danielulloa/dual_ad9833_scpi/informe_ulloa_daniel.pdf

## GENERADOR DE SENALES ˜

Daniel Ulloa
Departmento de Electronica ´ UNPSJB
Comodoro Rivadavia, 9000
ulloa@ieee.org

28 de junio de 2021

ABSTRACT

Desarrollo y fabricacion de un Generador de Se ´ | nales de dos Canales utilizando m ˜ | odulos AD9833 y ´
Arduino Uno. El intrumento puede ser programado utilizando el protocolo SCPI-1993 en formato de
texto plano a traves del puerto serie emulado por el conversor USB-TTL del Arduino Uno. Se logr ´ | ó
el ajuste de offset y ganancia con amplificadores operacionales, utilizando un circuito integrado MAX232 para generar la tension sim ´ etrica a partir de los 5V del puerto USB. ´

### 1. Objetivos

La catedra de Instrumentos y Mediciones 2 plante ´ | o el desarrollo de un instrumento digital que sea capaz de: ´

Generar dos senales ˜

Forma de onda seleccionable

Control de nivel DC offset a la salida

Control externo de la frecuencia

Control externo de la amplitud de salida

Se debe utilizar un Arduino Uno y modulos AD9833. ´

### 2. Decisiones de Disenõ

Para cumplir con los primeros dos objetivos el uso del modulo AD9833 permite una frecuencia de salida de 0 a ´ 12.5MHz y tres formas de onda seleccionables mediante configuracion de registros internos. ´

Respecto al control de offset y amplitud se analizo la posibilidad de utilizar un potenci ´ | ometro digital X9C10x que ´
requiere de una tension sim ´ | etrica de ´ | ±5V. Para generar esta tension s ´ | olo se encontr ´ | o el circuito integrado ICL7660 ´
pero no disponible localmente. La desventaja de utilizar un potenciometro digital es que s ´ | olo se podr ´ | ía atenuar la
frecuencia y la senal estar ˜ | ía limitada a ± 5V. Si se utilizara como resistencia de realimentaci ´ | on en un amplificador ´
operacional en configuracion no inversor se ver ´ | ía afectada su funcion de transferencia ya que el modelo de peque ´ | nã
senal est ˜ | a compuesto por capacitancias par ´ | asitas y la excursi ´ | on tambi ´ | en seguir ´ | ía limitada a ± 5V.

Para alimentar el amplificador operacional sería posible utilizar un circuito integrado MAX232, 2 capacitores de
bootstrap y 2 capacitores de filtrado para que genere una tension sim ´ | etrica de ´ | ± 8V a partir de los 5V disponibles.

Respecto al control de offset, el modulo AD9833 tiene un offset siempre positivo y es por esto que, se analiza la ´ posibilidad de utilizar una senal PWM filtrada para tener un valor de continua y un amplificador operacional en ˜
configuracion restador lo que permitiría desplazar a valores negativos la senal. Una alternativa ser ˜ | ía el uso de un
modulo DAC ya que la se ´ | nal PWM filtrada contiene una componente fundamental de 490Hz. ˜

Generador de Senales ˜

Para el control de ganancia una configuracion no inversor era la ´ | unica opci ´ | on ya que el mayor n ´ | umero de amplifi- ´
cadores operacionales en un circuito integrado es de 4 unidades, quedando dos disponibles para esta operacion. Una ´
configuracion inversor seguido de otro inversor de ganancia unitaria permitir ´ | | ía atenuacion y ganancia. Para ajustar la ´
realimentacion se estudia la posibilidad de utilizar un Optoaislador Resistivo fabricado utilizando un LDR de 5mm y ´ un LED Verde de 5mm, que podría ser controlado con otro puerto PWM del microcontrolador.
Para el control externo de la amplitud de salida de forma tal de obtener una senal modulada, no se encontr ˜ | o una ´
solucion. ´

Adicionalmente se propone la implementacion del protocolo SCPI-1993 que permite automatizar un banco de instru- ´ mentos, siendo posible el ajuste de parametros mediante software. ´

### 3. Esquema

El siguiente esquema representa una posible implementacion que permite el control de la ganancia y offset. Se utilizar ´ | ía
un lazo de realimentacion con un circuito muestreador que permita realizar la medici ´ | on de amplitud. ´

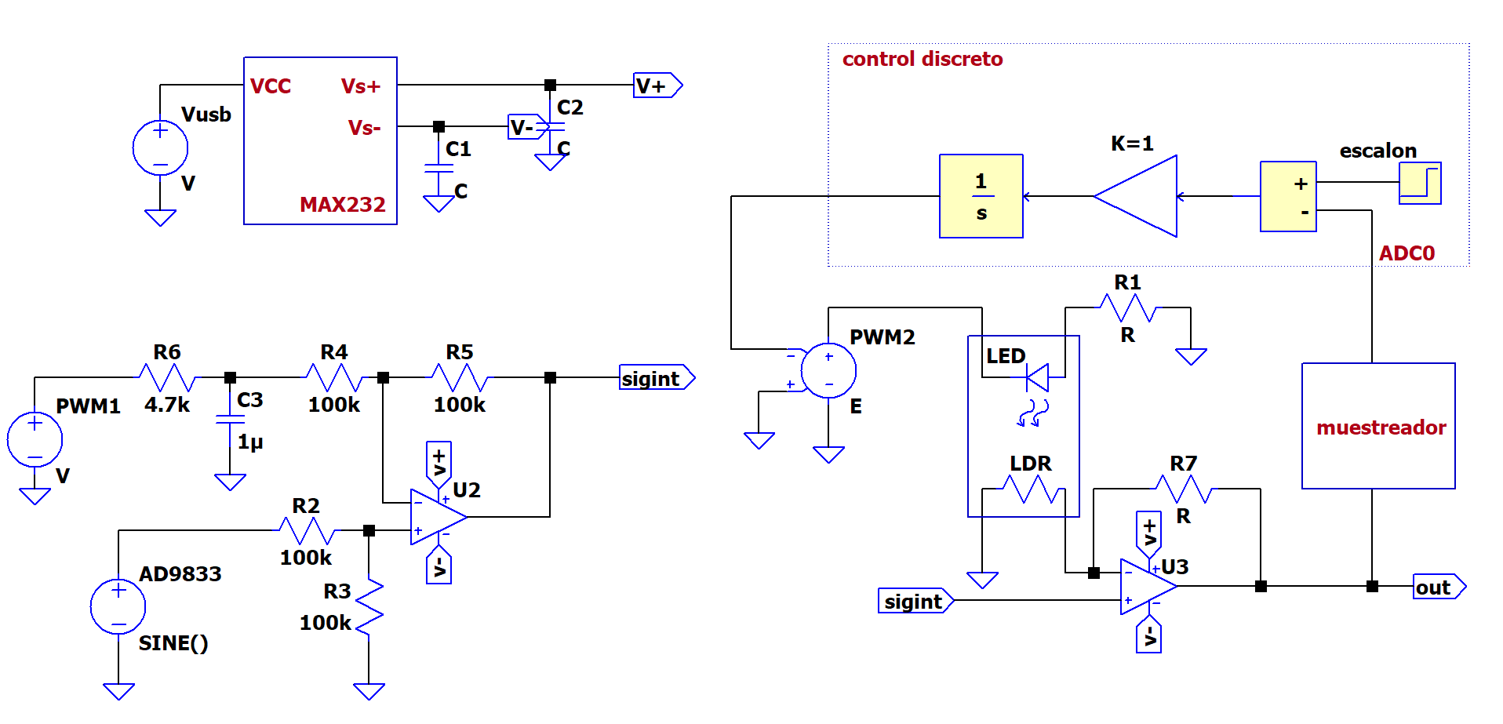
[picture p3: figure]

Figura 1: Primer esquema planteado, requiere de controlador discreto implementado en el microncontrolador

El problema de esta implementacion es que requiere de un circuito tal que detecte la envolvente para un amplio rango ´ de frecuencias.

Realizando un ensayo del LDR, que consitía de un divisor resistivo conectado a un puerto ADC del microcontrolador
y un LED verde frente al LDR con una senal PWM de 8 bits, se encontr ˜ | o que era posible utilizarlo en una regi ´ | on lineal ´
dependiente de un rango de valores PWM.

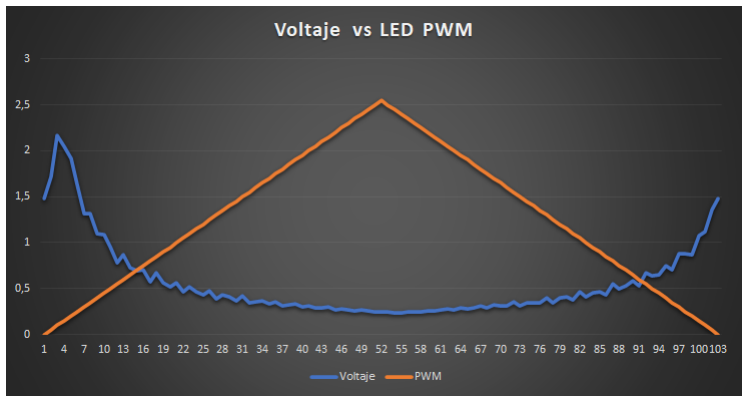
[picture p4: figure]

Figura 2: Barrido del ancho de pulso de la senal PWM para obtener la caracter ˜ | ística del LDR

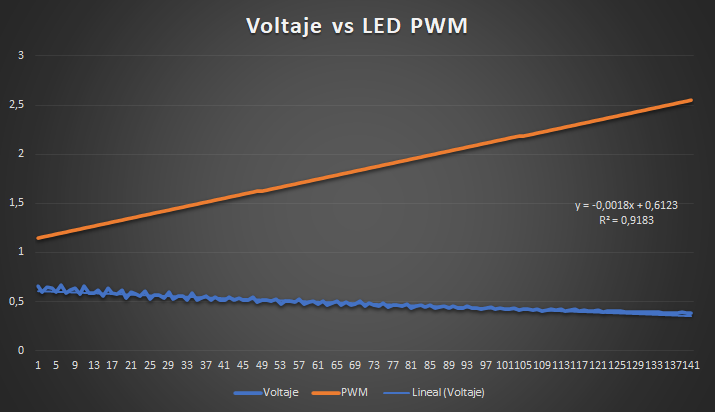
[picture p5: figure]

Figura 3: Limitando el rango a valores entre 115 y 255 se obtiene una recta, se verifica mediante una regresion lineal ´ que el coeficiente R es de 0.918

En base a los resultados del ensayo se limito el ancho de pulso que ser ´ | ía controlado por el software para ajustar la
ganancia de la senal de salida. El esquema final no implementa el lazo de realimentaci ˜ | on. ´

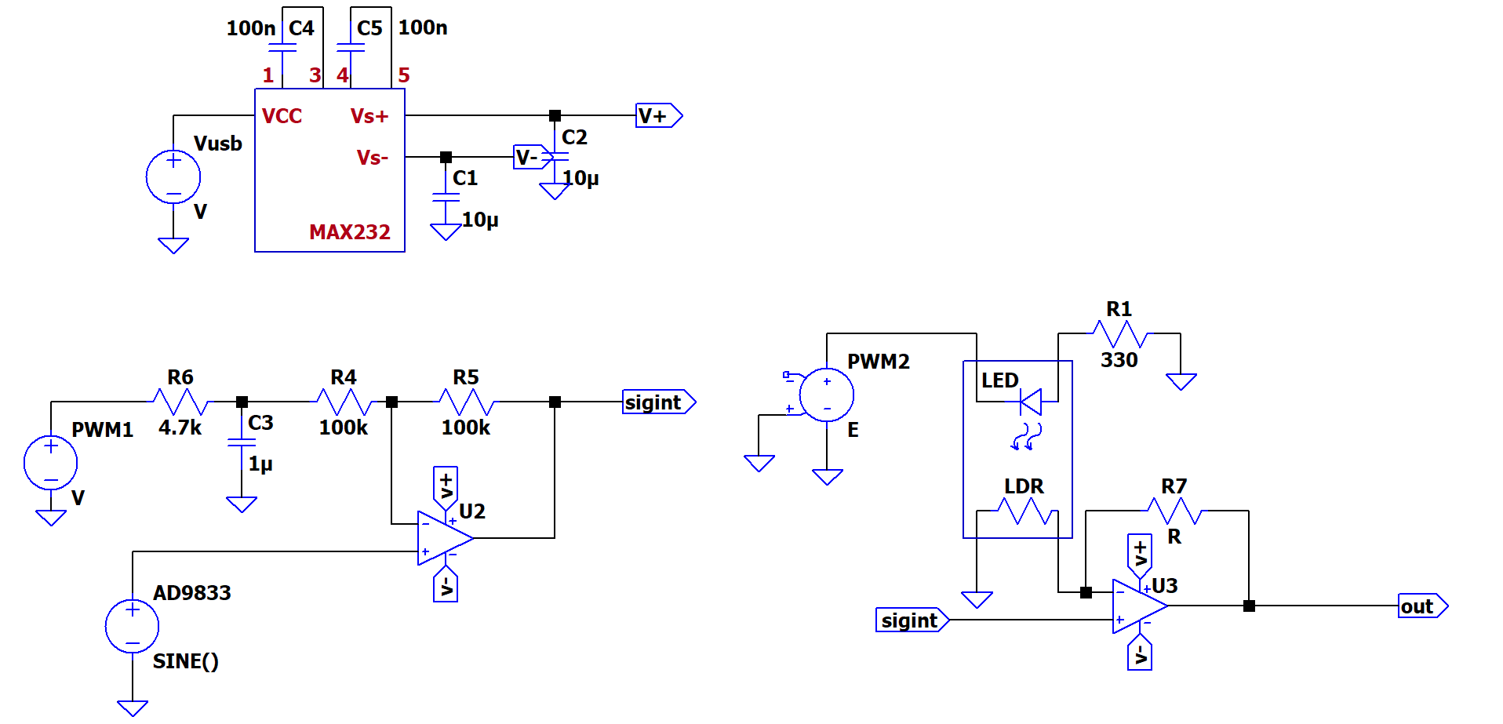
[picture p6: figure]

Figura 4: Esquema final, utiliza al LDR en su region lineal lo que permite obviar el esquema de control para el elemento ´ no lineal

### 4. Etapa de Prototipo

Primero era necesario verificar el funcionamiento de la fuente implementada con MAX232 y si la corriente era sufi-
ciente para alimentar un amplificador operacional cuadruple. Se dispon ´ | ía de un amplificador operacional OPA4277 y
un OPA4228, a continuacion sus caracter ´ | ísticas y motivos de eleccion. ´
IC | OPA4228 | OPA4277
GBW | 8MHz | 1MHz
SR | 2.3V/us | 0.8V/us
THD | 0.00005 % | 0.002 %
PSRR | 126dB | 130dB
Offset | ±75uV | ±10uV
Input Bias | 10nA | 1nA

La tension de alimentaci ´ | on provista por el MAX232 contiene ruido de alta frecuencia y es por esto que se eligi ´ | ó
el OPA4277 aunque sus características de alta frecuencia limitan la frecuencia maxima de operaci ´ | on. En teor ´ | ía sería
necesario el uso de un amplificador operacional con un producto ganancia superior a 100MHz para tener una tension de ´ salida de 5Vpp y un Slew Rate superior a 390V/us. Si se limita la frecuencia maxima para la onda cuadrada a 20kHz el ´ SR debe ser superior a 0.628V/us, por lo tanto el OPA4277 cumple. En el caso de querer mejorar la frecuencia maxima ´ conservando el formato DIP de 14 pines, un amplificador operacional con las características mencionadas podría ser LT1230CN u OPA4658P, pero no se encuentran disponibles en nuestro país y sería necesaria su importacion mediante ´ un distribuidor internacional.

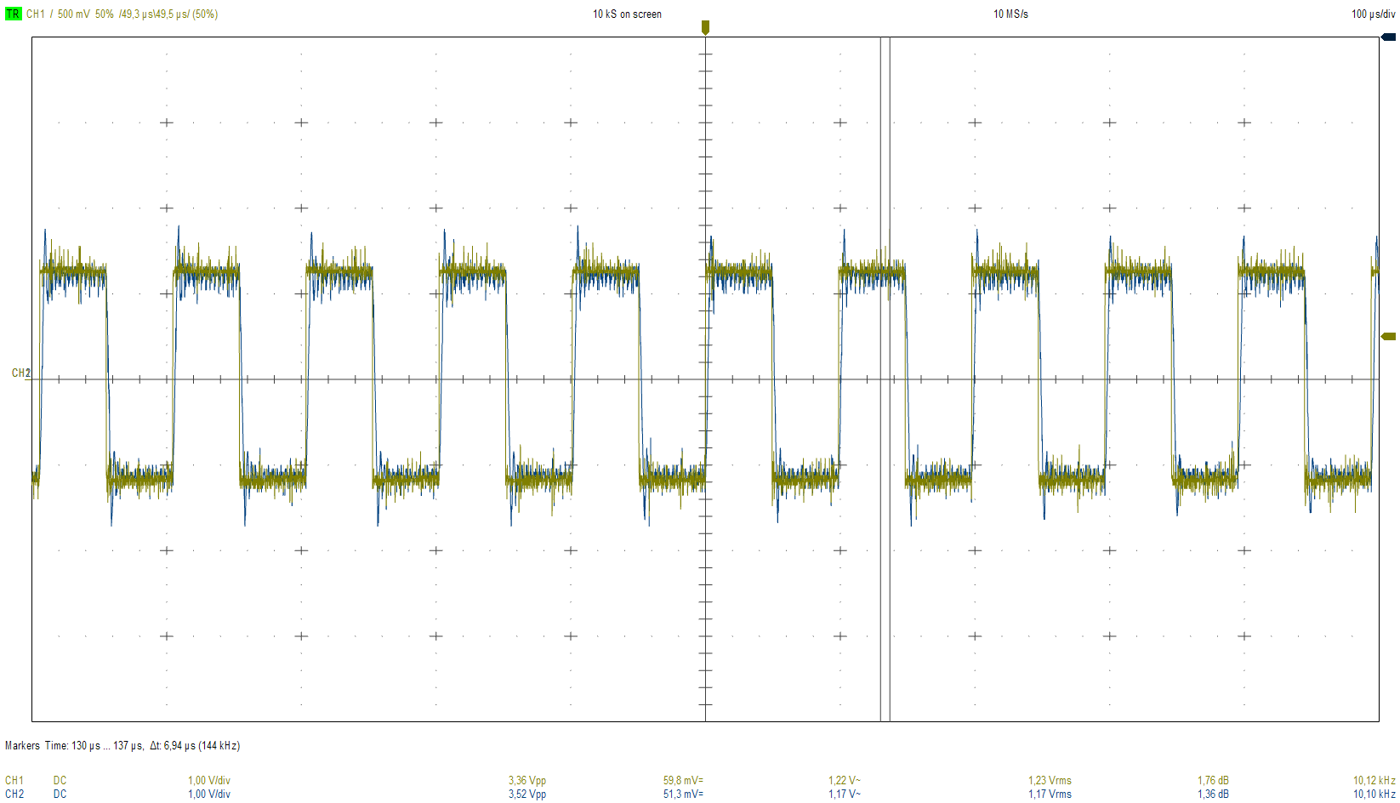
[picture p7: figure]

Figura 5: Implementacion en protoboard. Se observa un ruido de alta frecuencia del generador de funciones utilizado ´ para el ensayo.

Los resultados obtenidos fueron satisfactorios y se decidio implementar el circuito en un ProtoShield para Arduino, ´
que dispone de un area limitada para soldar los componentes de todo el circuito, pero con las t ´ | ecnicas adecuadas y ´
disposicion de los componentes ser ´ | ía posible minimizar el ruido. Al momento de probar la placa se encontro que el ´
circuito integrado MAX232 era defectuoso lo cual aumentaba el ruido así como tambien una reducci ´ | on en su voltaje ´
simetrico, de aproximadamente 3V. Con un nuevo circuito integrado se obtuvo una tensi ´ | on sim ´ | etrica de ´ | ±8.8V

### 5. Mediciones

Se realizaron mediciones con un osciloscopio Hantek 6022BE de dos canales y un ancho de banda de 20MHz.

Se encontro que la frecuencia m ´ | axima para una onda cuadrada fue de 20kHz a pesar de que la se ´ | nal comenzaba a ser ˜
trapezoidal, pero cumpliendo con el objetivo en funcion al slewrate del amplificador operacional. ´
En el caso de la senal senoidal se observ ˜ | o que a partir de 165kHz se produc ´ | ía un desfasaje en la senal de salida, ˜
probablemente por la presencia de un polo en el sistema. No se realizaron pruebas con el amplificador operacional
OPA4228 porque se cometio el error de no utilizar un z ´ | ocalo en la placa que permitiese el cambio. Se llevaron a cabo ´
otras mediciones que quedaron plasmadas en el manual de usuario en la seccion de caracter ´ | | ísticas.

### 5.1. Firmware

La programacion de la placa Arduino Uno se realiz ´ | o en el lenguaje C bajo el IDE Visual Studio Code porque mejora ´
la navegabilidad del codigo y facilidad en la escritura ya que implementa autocompletado. Respecto a las bibliotecas ´
utilizadas, para la implementacion del protocolo SCPI se utiliz ´ | o una biblioteca desarrollada por Lachlan Gunn en ´
el ano 2013 que debi ˜ | o ser modificada para ser compatible con la versi ´ | on de Arduino 1.8.15. Para el control de los ´
modulos AD9833 se utiliz ´ | o la biblioteca Majic Designs AD9833 por su desarrollo activo. ´
El codigo consta de unas 700 lineas, en su mayor ´ | ía destinadas a la sintaxis de los comandos del protocolo SCPI. El lazo
principal espera la ocurrencia de un evento del puerto serie, si se trata de un comando valido se ejecuta una acci ´ | | | on. Por ´
ejemplo al recibir el comando :AWG1:FREQ 10e3 se ajusta la frecuencia del modulo mediante las funciones provistas ´

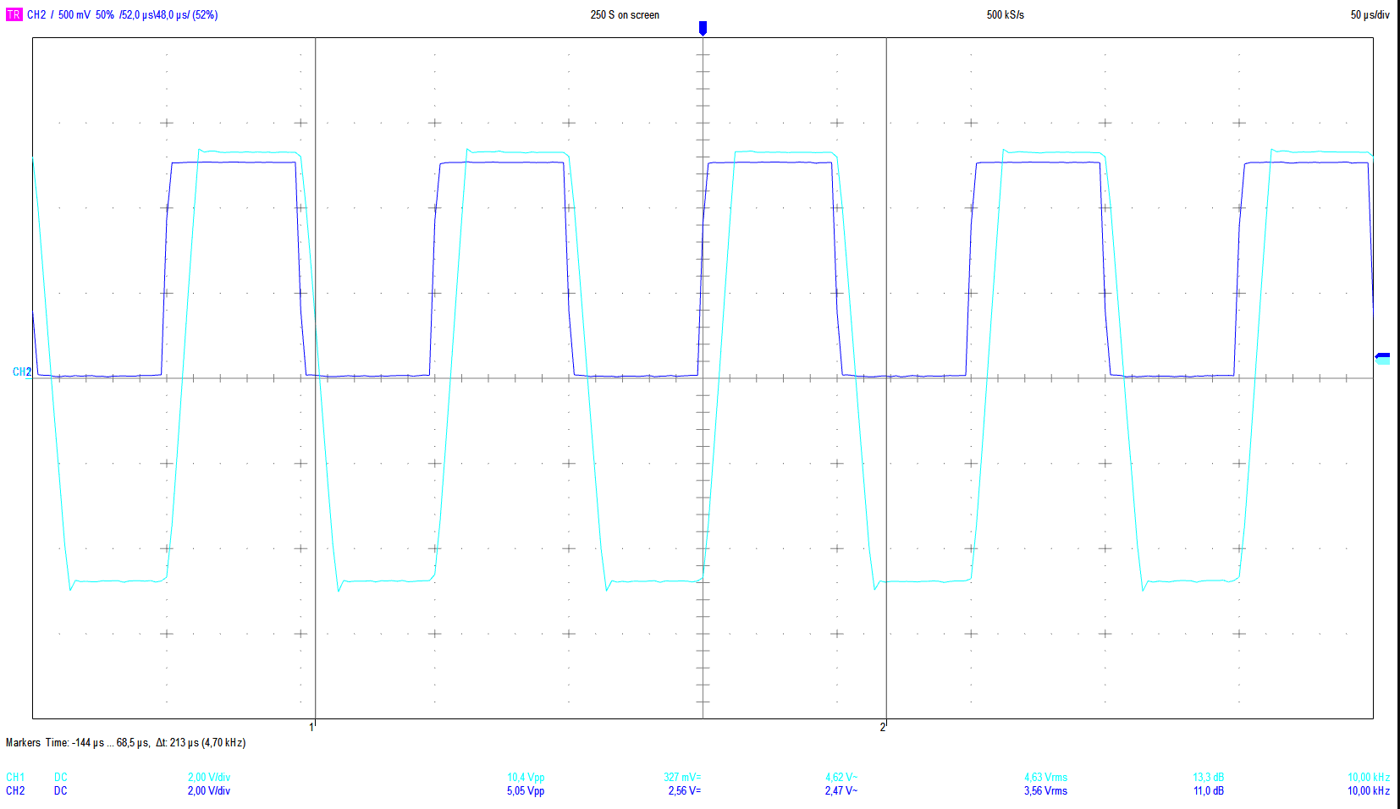
[picture p8: figure]

Figura 6: La senal previa a las etapas de ganancia y offset tiene una amplitud de 5Vpp y 2.5V de offset. Se observa el ˜ efecto del slewrate.

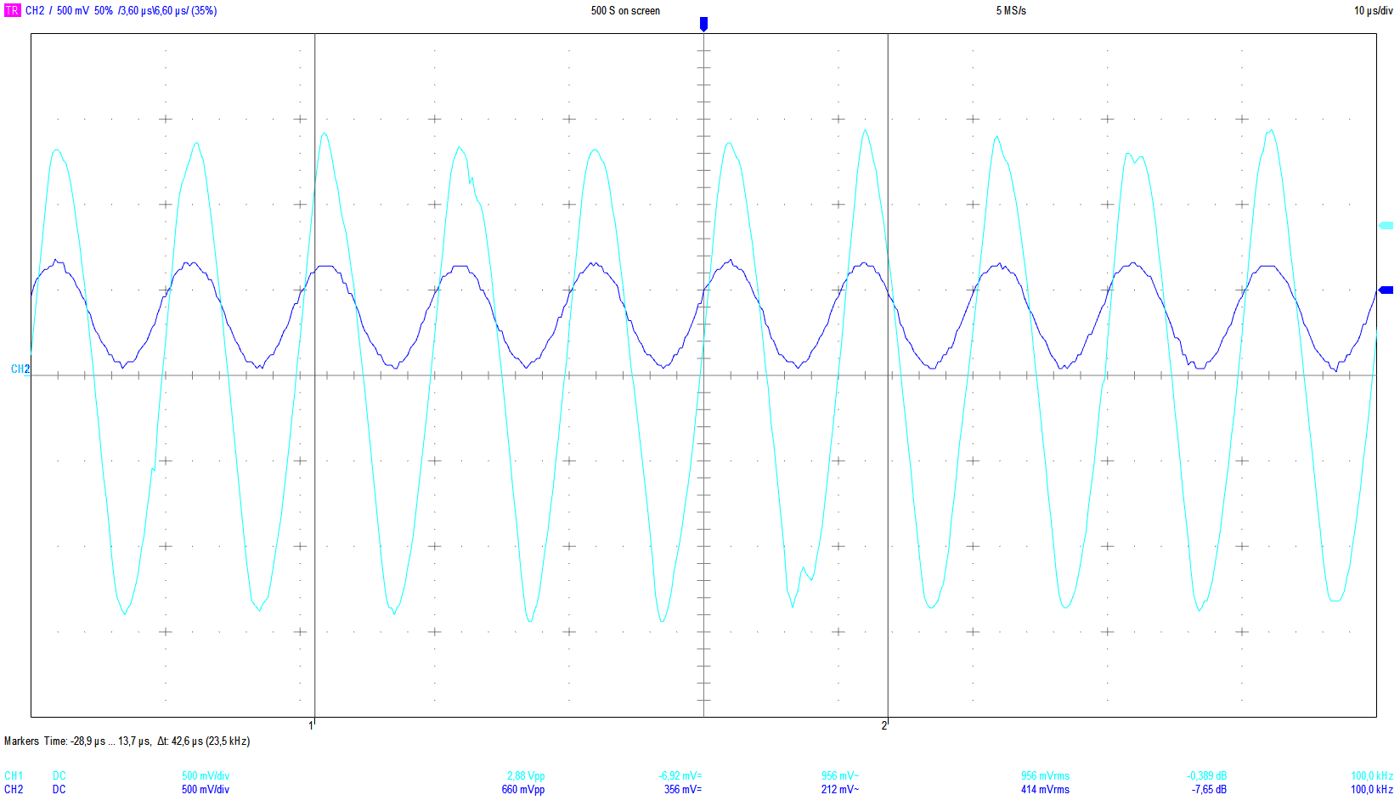
[picture p9: figure]

Figura 7: Realizando ajustes en la frecuencia para encontrar la frecuencia maxima de operaci ´ | on de la etapa anal ´ | ogica. ´

por la biblioteca del AD9833. Para realizar la implementacion del barrido de frecuencia es necesario entrar en un lazo ´
infinito y para romperlo se recurre a una interrupcion para volver al lazo principal ante la recepci ´ | on de un comando. ´

Se decidio no utilizar unidades de voltaje para el offset y ganancia ya que de esta manera se pueden realizar calibracio- ´ nes mediante tablas por software. Otro de los motivos es porque al utilizar un LDR como elemento de realimentacion´
no se tiene una respuesta lineal lo cual dificulta la eleccion de las resistencias para el amplificador operacional. Ser ´ | ía
necesario un proceso de apareamiento de los LDR y LED para lograr que ambos canales respeten el rango deseado para un mismo ancho de pulso PWM. Al momento de conectar el instrumento al puerto USB sus salidas se activan generando una senal de 1kHz en cuadratura, teniendo una fuente de referencia sin la necesidad de ejecutar software ˜ para su configuracion. ´

En el manual de usuario se provee la lista de comandos implementados así como tambien el uso de un script de Python ´ para realizar la ejecucion de una serie de comandos, de esta manera se demuestra que es posible realizar una prueba ´ automatizada de un circuito bajo estudio con el instrumento desarrollado.

### 6. Interfaz grafica ´

Se desarrollo en Processing P5 una interfaz gr ´ | afica para comandar el instrumento, haber implementado el protocolo ´
SCPI redujo la complejidad del codigo ya que s ´ | olo se necesita iniciar la comunicaci ´ | on serial con el instrumento y ante ´
eventos en los elementos graficos de la interfaz enviar los comandos por el puerto serie. ´
Para los elementos graficos se utiliz ´ | o la biblioteca ControlP5 y para la comunicaci ´ | on serie Processing Serial. Se eligi ´ | ó
un formato de dos paneles para identificar rapidamente cada canal, un conjunto de perillas permite el ajuste del offset ´ y la amplitud. Mediante deslizadores se puede ajustar la frecuencia y la fase. Para realizar barridos existe una seccion del panel destinada a este fin, donde se puede ajustar los parametros de frecuencia de inicio, frecuencia final, tiempo ´ de barrido.

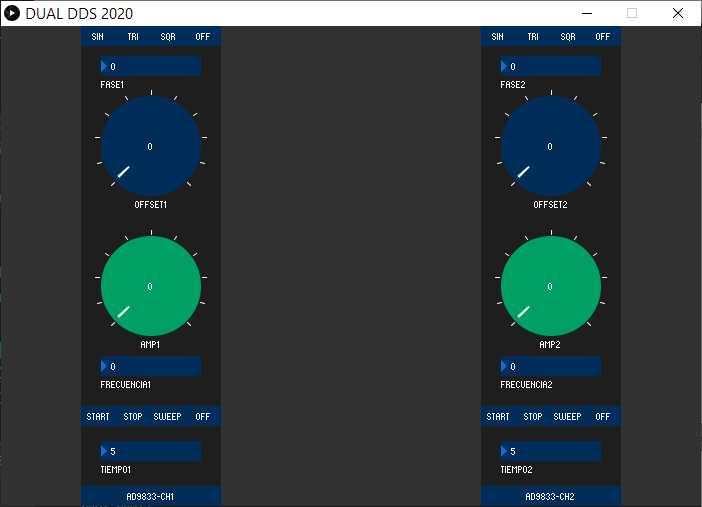
[picture p10: figure]

Figura 8: Interfaz grafica desarrollada en Processing P5 ´

### 7. Mejoras

Respecto al hardware sería recomendable el uso de otro amplificador operacional que permita extender la frecuencia
de operacion. Si se quitara la restricci ´ | | on de ser un dispositivo port ´ | atil que no requiere de fuente externa, se podr ´ | | ía
disenar una fuente de alimentaci ˜ | on sim ´ | etrica y as ´ | í poder extender la excursion. Tambi ´ | en se podr ´ | ía agregar una etapa
TTL que permita generar una senal cuadrada que no se vea afectada por el slewrate del amplificador operacional ˜
elegido, para esto queda una seccion en la placa donde ser ´ | ía necesario el uso de tecnología SMD. Se podría utilizar un
buffer Schmitt Trigger, conectado en paralelo a la salida del modulo AD9833 y obtener una se ´ | nal cuadrada de hasta ˜
12.5MHz, que tambien podr ´ | ía ser utilizada como fuente de trigger para un osciloscopio.
Respecto al firmware se podría implementar un barrido logarítmico. Tambien se podr ´ | ía agregar una entrada de sincro-
nismo que podría ser utilizada para disparar una interrupcion y ajustar alg ´ | un par ´ | ametro del m ´ | odulo, pero se deber ´ | ía
estudiar la forma de proteger al microcontrolador ya que estaría vulnerable a ESD, lo mismo si se agregara una entrada para realizar un barrido externo manual, sería necesaria proteger la entrada del ADC del microcontrolador. Si se
implementaran nuevos comandos SCPI para poder configurar el segundo registro de los modulos AD9833 se podr ´ | ía
realizar modulacion FSK y PSK, ya que se puede almacenar otro valor de frecuencia y fase para cada m ´ | | | | | odulo. ´

### 8. Conclusion´

Se logro implementar un generador de funciones de dos canales, forma de onda programable con offset y ganancia ´ ajustable, que a traves del protocolo SCPI-1993 se pueden configurar. El instrumento no requiere de drivers y es ´ independiente del sistema operativo utilizado.

Se optimizo el uso de pines del microcontrolador, conectando dos m ´ | odulos AD9833 al mismo puerto SPI y los pines de ´
Chip Select independientes, resultando en un total de 4 pines para la comunicacion SPI. Se utilizo salidas PWM en vez ´
de conversores DA que aumentarían los costos del dispositivo. Se implemento una fuente de alimentaci ´ | on sim ´ | etrica ´
con un circuito integrado de bajo costo y no fue necesaria la utilizacion de una provisi ´ | on de energ ´ | ía externa.

La implementacion del protocolo SCPI permite continuar estudiando los bancos de instrumentos automatizados ya ´ que nuestra universidad no cuenta con las interfaces necesarias para conectar los instrumentos que poseen el puerto GPIB del estandar IEEE-482. ´
